iamchriskelley/half-pint-turbidimeter/README.md

#The half-pint turbidimeter
###An awesome water quality monitor about the size of a fist.

Written description coming soon. For now, here's a photo.

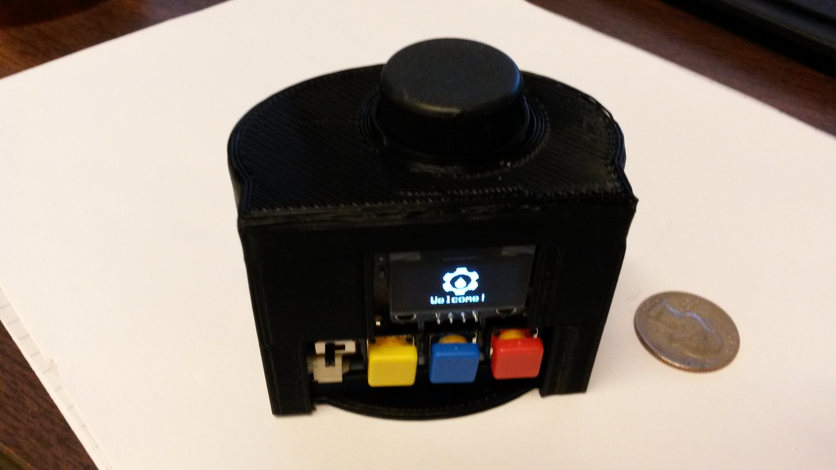
[picture p1: documentation/half-pint-turbidimeter_photo.jpg]
