iamchriskelley/half-pint-turbidimeter/hardware/half-pint-turbidimeter_tsl230rd_tsl267_1.0.1.brd

## EAGLE design hardware/half-pint-turbidimeter_tsl230rd_tsl267_1.0.1.brd (2017-01-15)

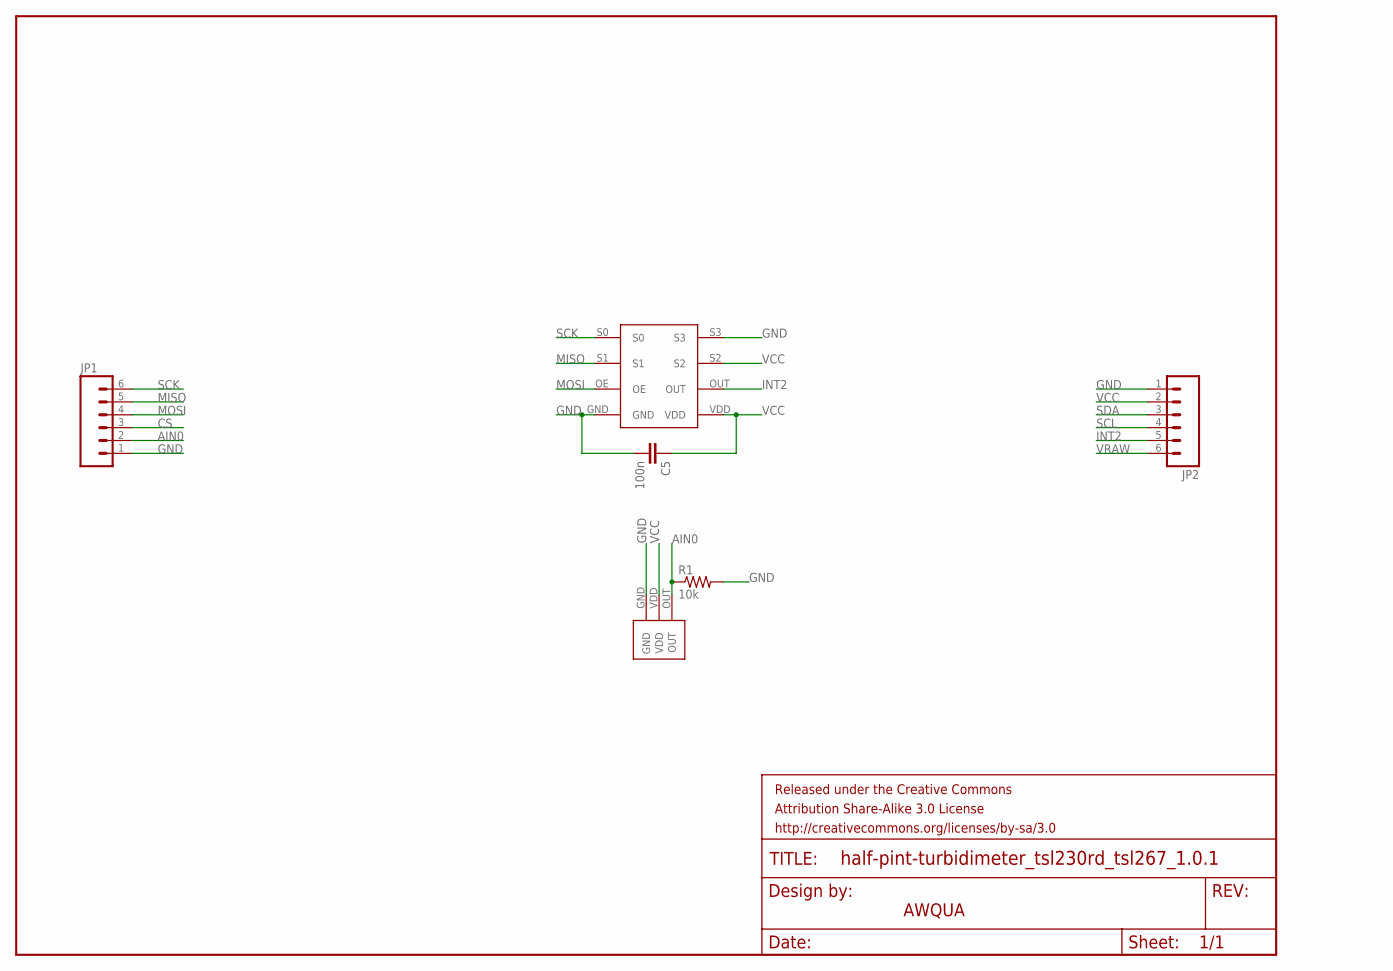
[picture p2: schematic half-pint-turbidimeter_tsl230rd_tsl267_1.0.1.sch]

Parts:
C5: 100n; 0603-CAP
FRAME1: FRAME-LETTER; CREATIVE_COMMONS
JP1, JP2: M06SIP; 1X06
R1: 10k; 0603-RES
U$1: TSL267
U$6: TSL230RDSMD; TSL230RD

Connections:
AIN0: JP1.2, R1.1, U$1.OUT
CS: JP1.3
GND: C5.2, JP1.1, JP2.1, R1.2, U$1.GND, U$6.GND, U$6.S3
INT2: JP2.5, U$6.OUT
MISO: JP1.5, U$6.S1
MOSI: JP1.4, U$6.OE
SCK: JP1.6, U$6.S0
SCL: JP2.4
SDA: JP2.3
VCC: C5.1, JP2.2, U$1.VDD, U$6.S2, U$6.VDD
VRAW: JP2.6

Notes on the sheet:
AWQUA

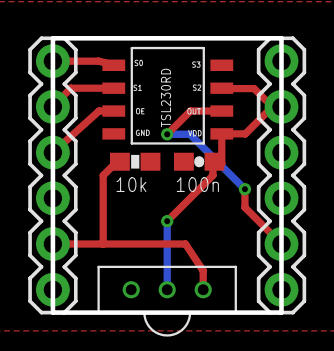
[picture p3: board half-pint-turbidimeter_tsl230rd_tsl267_1.0.1.brd from above]

Board: 2 copper layers, 12.7 x 15.2 mm, 8 parts (1 on the bottom side), 7 nets.

Other parts of the board:
U$5: OSHW-LOGO-S
