iamchriskelley/half-pint-turbidimeter/hardware/half-pint-turbidimeter_2.0.2.brd

## EAGLE design hardware/half-pint-turbidimeter_2.0.2.brd (2017-01-15)

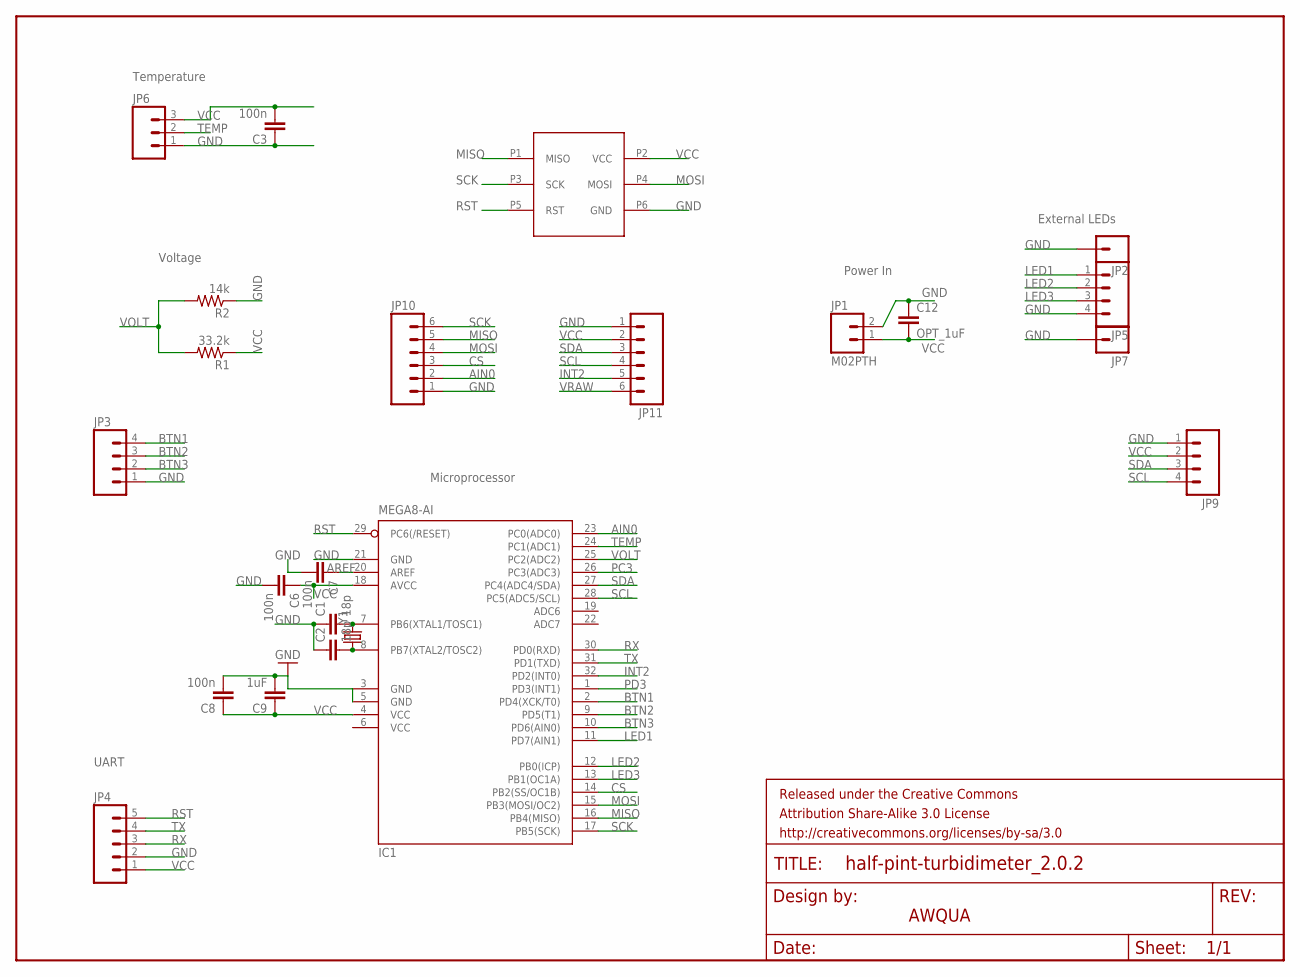
[picture p4: schematic half-pint-turbidimeter_2.0.2.sch]

Parts:
C1, C2: 18p; 0603-CAP
C3, C6, C7, C8: 100n; 0603-CAP
C9: 1uF; 0603-CAP
C12: OPT_1uF; 0603-CAP
FRAME1: FRAME-LETTER; CREATIVE_COMMONS
IC1: MEGA8-AI; TQFP32-08
JP1: M02PTH; 1X02
JP2, JP7: M01PTH; 1X01
JP3, JP5, JP9: M04PTH; 1X04
JP4: M05PTH; 1X05
JP6: M03PTH; 1X03
JP10, JP11: M06SMD_MALE; 1X06_SMD_MALE
R1: 33.2k; 0603-RES
R2: 14k; 0603-RES
U$1: ISP-SMD-6PIN
Y1: CRYSTAL5X3; CRYSTAL-SMD-5X3

Connections:
AIN0: IC1.23 (PC0(ADC0)), JP10.2
AREF: C7.1, IC1.20 (AREF)
BTN1: IC1.2 (PD4(XCK/T0)), JP3.4
BTN2: IC1.9 (PD5(T1)), JP3.3
BTN3: IC1.10 (PD6(AIN0)), JP3.2
CS: IC1.14 (PB2(SS/OC1B)), JP10.3
GND: C1.1, C2.1, C3.1, C6.2, C7.2, C8.2, C9.2, C12.1, IC1.3 (GND), IC1.5 (GND), IC1.21 (GND), JP1.2, JP2.1, JP3.1, JP4.2, JP5.4, JP6.1, JP7.1, JP9.1, JP10.1, JP11.1, R2.1, U$1.P6 (GND)
INT2: IC1.32 (PD2(INT0)), JP11.5
LED1: IC1.11 (PD7(AIN1)), JP5.1
LED2: IC1.12 (PB0(ICP)), JP5.2
LED3: IC1.13 (PB1(OC1A)), JP5.3
MISO: IC1.16 (PB4(MISO)), JP10.5, U$1.P1 (MISO)
MOSI: IC1.15 (PB3(MOSI/OC2)), JP10.4, U$1.P4 (MOSI)
PC3: IC1.26 (PC3(ADC3))
PD3: IC1.1 (PD3(INT1))
Q1: C2.2, IC1.8 (PB7(XTAL2/TOSC2)), Y1.1
Q2: C1.2, IC1.7 (PB6(XTAL1/TOSC1)), Y1.3 (2)
RST: IC1.29 (PC6(/RESET)), JP4.5, U$1.P5 (RST)
RX: IC1.30 (PD0(RXD)), JP4.3
SCK: IC1.17 (PB5(SCK)), JP10.6, U$1.P3 (SCK)
SCL: IC1.28 (PC5(ADC5/SCL)), JP9.4, JP11.4
SDA: IC1.27 (PC4(ADC4/SDA)), JP9.3, JP11.3
TEMP: IC1.24 (PC1(ADC1)), JP6.2
TX: IC1.31 (PD1(TXD)), JP4.4
VCC: C3.2, C6.1, C8.1, C9.1, C12.2, IC1.4 (VCC), IC1.6 (VCC), IC1.18 (AVCC), JP1.1, JP4.1, JP6.3, JP9.2, JP11.2, R1.1, U$1.P2 (VCC)
VOLT: IC1.25 (PC2(ADC2)), R1.2, R2.2
VRAW: JP11.6

Notes on the sheet:
AWQUA
Temperature
Voltage
UART
Microprocessor
Power In
External LEDs

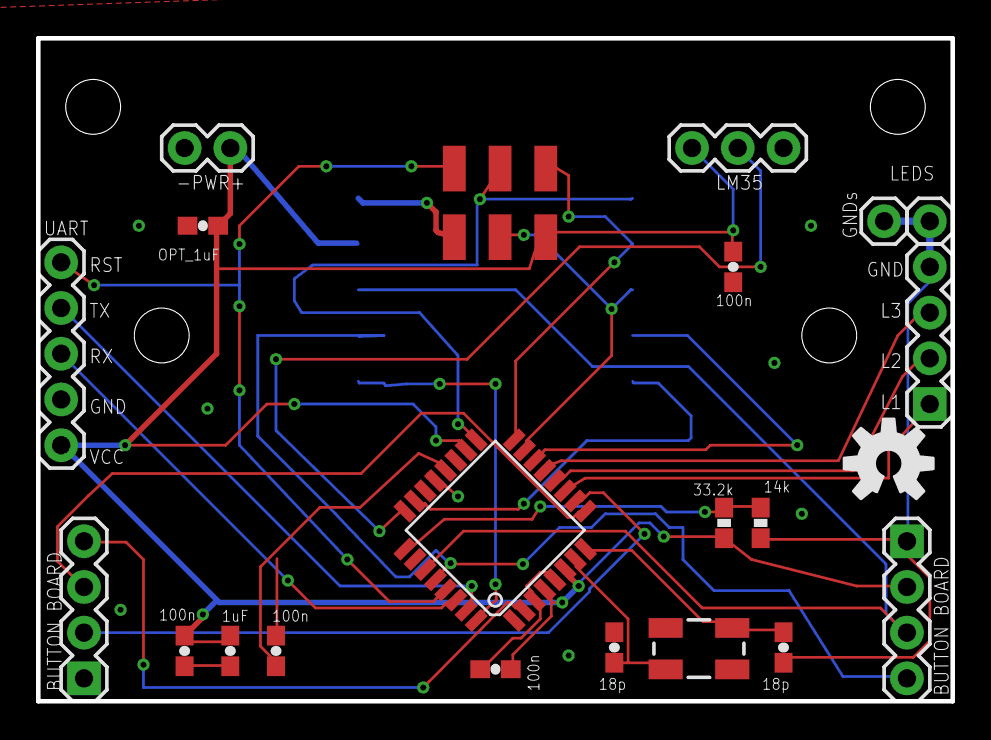
[picture p5: board half-pint-turbidimeter_2.0.2.brd from above]

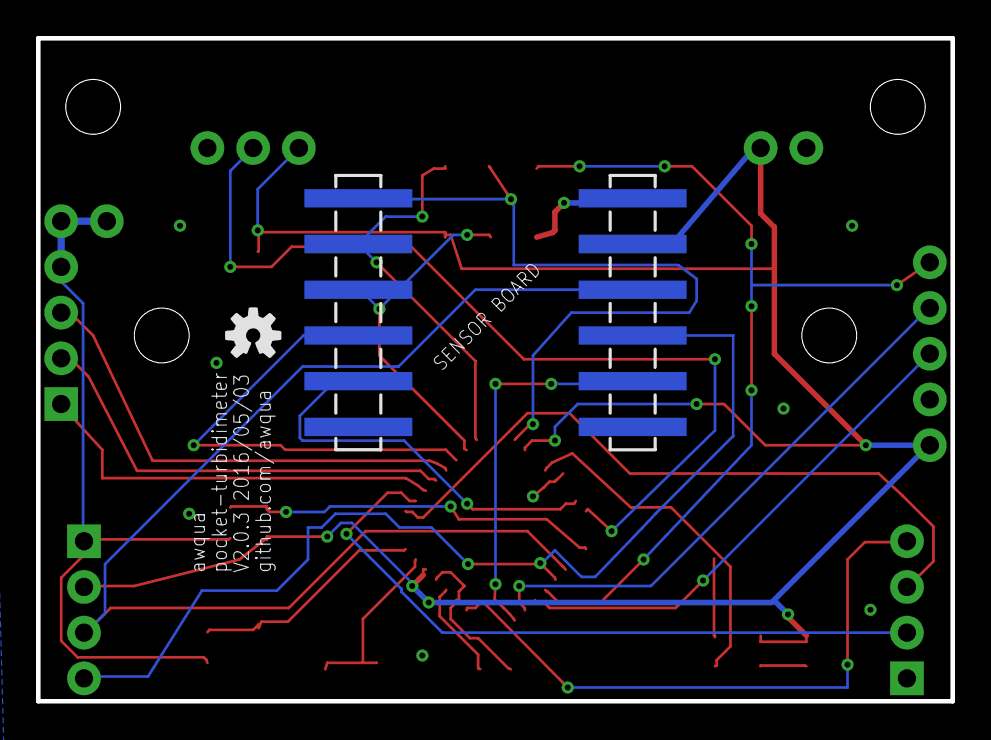
[picture p6: board half-pint-turbidimeter_2.0.2.brd from below]

Board: 2 copper layers, 50.8 x 36.8 mm, 26 parts (3 on the bottom side), 24 nets.

Other parts of the board:
U$4: OSHW-LOGO-M
U$5: OSHW-LOGO-S
