iamchriskelley/half-pint-turbidimeter/hardware/half-pint-turbidimeter_power.brd

## EAGLE design hardware/half-pint-turbidimeter_power.brd (2016-04-19)

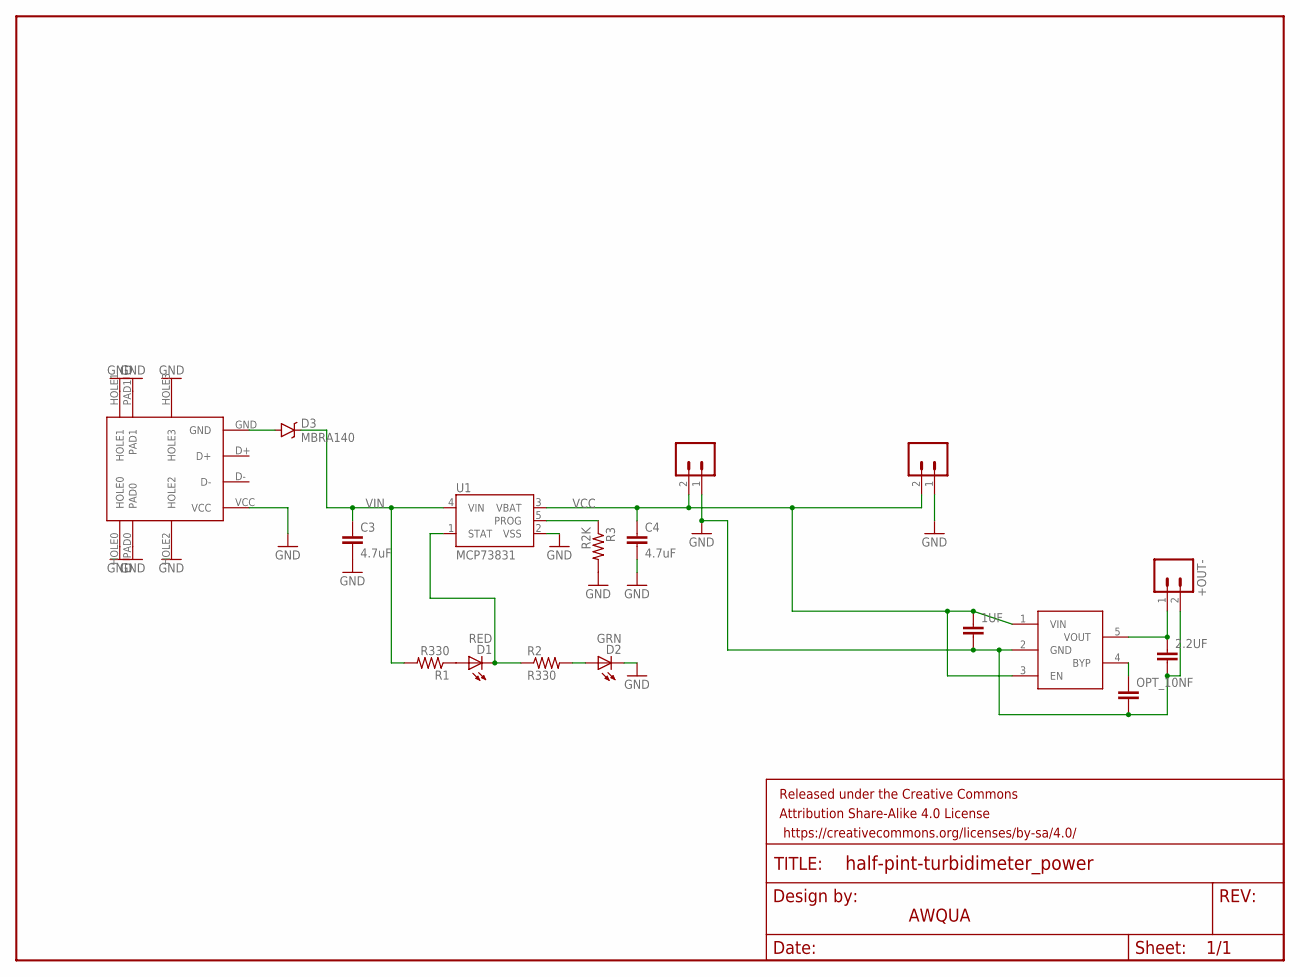
[picture p7: schematic half-pint-turbidimeter_power.sch]

Parts:
1UF, 2.2UF: CAP0603-CAP; 0603-CAP
+OUT-: M02PTH; 1X02
C3, C4: 4.7uF; 0402-CAP
D1: RED; LED-0603
D2: GRN; LED-0603
D3: MBRA140; SMA-DIODE
FRAME1: FRAME-LETTER; CREATIVE_COMMONS
JMP: M02PTH; 1X02
JP7: LiPo Battery; JST-2-SMD
OPT_10NF: CAP0603-CAP; 0603-CAP
R1, R2: R330; 0402-RES
R3: R2K; 0402-RES
U1: MCP73831; SOT23-5
U$2: LP2985
U$3: USBMICRO-DX4R005JJ2

Connections:
GND: 1UF.2, 2.2UF.2, +OUT-.2, C3.2, C4.2, D2.C, JMP.1, JP7.1, OPT_10NF.2, R3.2, U1.2 (VSS), U$2.2 (GND), U$3.HOLE0, U$3.HOLE1, U$3.HOLE2, U$3.HOLE3, U$3.PAD0, U$3.PAD1, U$3.VCC
unnamed: OPT_10NF.1, U$2.4 (BYP)
unnamed: D2.A, R2.2
unnamed: D1.A, R1.1
unnamed: 2.2UF.1, +OUT-.1, U$2.5 (VOUT)
unnamed: D3.A, U$3.GND
PROG: R3.1, U1.5 (PROG)
STAT: D1.C, R2.1, U1.1 (STAT)
VCC: 1UF.1, C4.1, JMP.2, JP7.2, U1.3 (VBAT), U$2.1 (VIN), U$2.3 (EN)
VIN: C3.1, D3.C, R1.2, U1.4 (VIN)

Notes on the sheet:
AWQUA

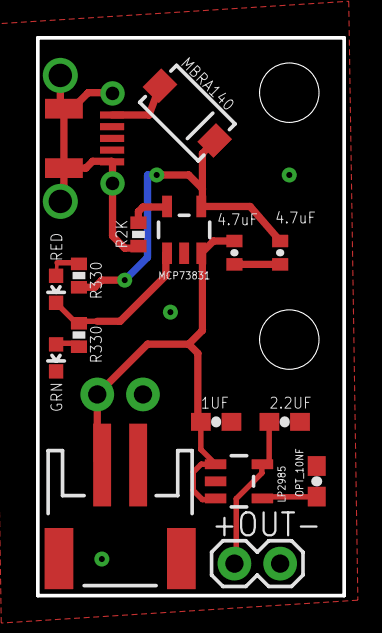
[picture p8: board half-pint-turbidimeter_power.brd from above]

Board: 2 copper layers, 17.0 x 31.0 mm, 21 parts (1 on the bottom side), 10 nets.

Other parts of the board:
JP1, JP3: STAND-OFF
U$1: CREATIVE_COMMONS
