iamchriskelley/half-pint-turbidimeter/hardware/half-pint-turbidimeter_led.brd

## EAGLE design hardware/half-pint-turbidimeter_led.brd (2016-03-31)

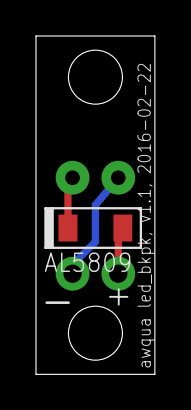
[picture p9: board half-pint-turbidimeter_led.brd from above]

Board: 2 copper layers, 6.6 x 18.8 mm, 4 parts (1 on the bottom side), 3 nets.

Parts:
D1: LED5MM
JP1: 1X02_NO_SILK
U$1: AL5809
U$2: CREATIVE_COMMONS

Connections:
$N1: D1.A, U$1.OUT
GND: D1.K, JP1.1
VCC: JP1.2, U$1.IN
