iamchriskelley/half-pint-turbidimeter/hardware/half-pint-turbidimeter_controls_2.0.1.brd

## EAGLE design hardware/half-pint-turbidimeter_controls_2.0.1.brd (2016-03-29)

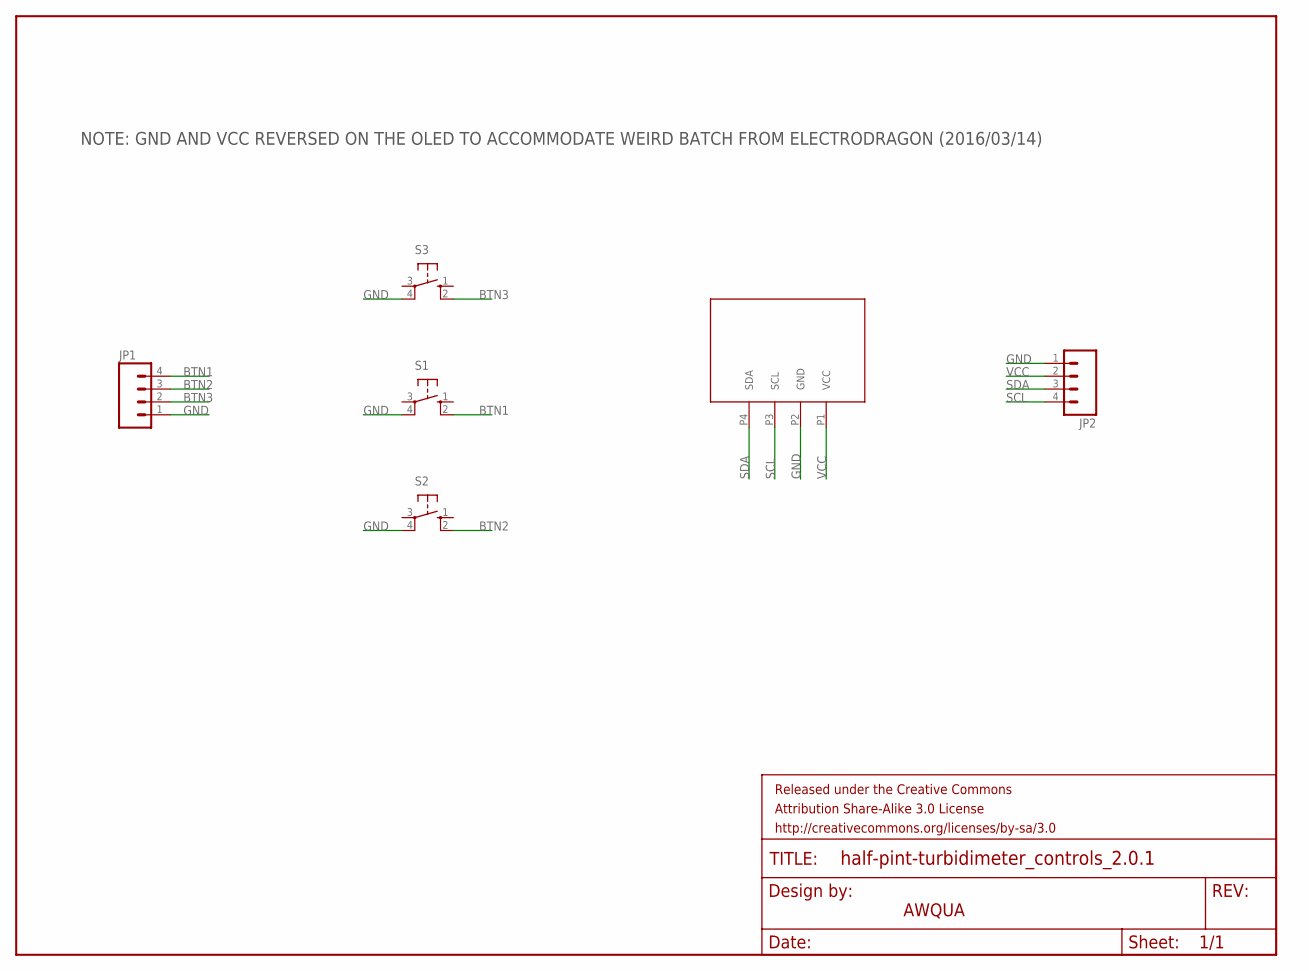
[picture p10: schematic half-pint-turbidimeter_controls_2.0.1.sch]

Parts:
FRAME1: FRAME-LETTER; CREATIVE_COMMONS
JP1, JP2: M04PTH; 1X04
S1, S2, S3: 40-XX; B3F-40XX
U$2: I2C-OLED-096

Connections:
BTN1: JP1.4, S1.2 (S1)
BTN2: JP1.3, S2.2 (S1)
BTN3: JP1.2, S3.2 (S1)
GND: JP1.1, JP2.1, S1.4 (P1), S2.4 (P1), S3.4 (P1), U$2.P2 (GND)
SCL: JP2.4, U$2.P3 (SCL)
SDA: JP2.3, U$2.P4 (SDA)
VCC: JP2.2, U$2.P1 (VCC)

Notes on the sheet:
AWQUA
NOTE: GND AND VCC REVERSED ON THE OLED TO ACCOMMODATE WEIRD BATCH FROM ELECTRODRAGON (2016/03/14)

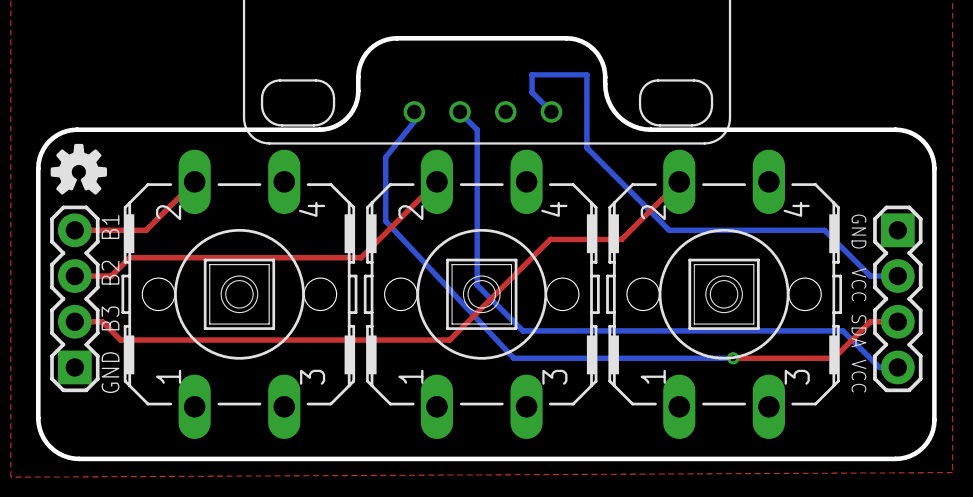
[picture p11: board half-pint-turbidimeter_controls_2.0.1.brd from above]

Board: 2 copper layers, 49.8 x 23.4 mm, 9 parts (1 on the bottom side), 7 nets.

Other parts of the board:
U$1: OSHW-LOGO-S
U$4: OSHW-LOGO-M
