iamchriskelley/half-pint-turbidimeter/testing/half_pint_turbidimeter_testing_20160509.xlsx

Half-pint turbidimeter calibration, 2016/05/09, for Cornell POST team
Validation data
Half-pint turbidimeter readings |  |  | MicroTPI readings |  |  | mean(half-pint) | mean(microtpi) | NTU difference | % difference
495.9 | 494.12 | 495.66 | 502.8 | 502.5 | 502.8 | 502.7 | 495.2266667 | 7.473333333 | 0.01486638817
370.67 | 370.62 | 370.67 | 378.7 | 378.4 | 378.5 | 378.5333333 | 370.6533333 | 7.88 | 0.02081718915
288.8 | 288.42 | 288.03 | 290.5 | 289.8 | 291 | 290.4333333 | 288.4166667 | 2.016666667 | 0.006943647423
153.86 | 153.29 | 153.16 | 147 | 147.9 | 163.5 | 152.8 | 153.4366667 | -0.6366666667 | -0.004166666667
74.98 | 75.09 | 75.14 | 72.86 | 72.98 | 73.12 | 72.98666667 | 75.07 | -2.083333333 | -0.02854402631
34.5 | 34.43 | 34.48 | 33.75 | 34.29 | 34.63 | 34.22333333 | 34.47 | -0.2466666667 | -0.007207558196
19.52 | 19.49 | 19.55 | 18.51 | 18.63 | 18.68 | 18.60666667 | 19.52 | -0.9133333333 | -0.04908634898
6.81 | 6.81 | 6.79 | 6.73 | 6.83 | 6.69 | 6.75 | 6.803333333 | -0.05333333333 | -0.007901234568
3.39 | 3.38 | 3.44 | 3.33 | 3.11 | 3.08 | 3.173333333 | 3.403333333 | -0.23 | -0.0724789916
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
