iamchriskelley/half-pint-turbidimeter/(commit log)

2016-03-29 imported main, interface boards
    [half-pint-turbidimeter_2.0.1.brd, half-pint-turbidimeter_2.0.1.sch, half-pint-turbidimeter_controls_2.0.1.brd, half-pint-turbidimeter_controls_2.0.1.sch, half-pint-turbidimeter_controls_2.0.1__OLED_gnd_vcc_reversed.brd, half-pint-turbidimeter_controls_2.0.1__OLED_gnd_vcc_reversed.sch, half-pint-turbidimeter_led.brd, half-pint-turbidimeter_led.sch]
2016-03-30 next version started
    [half-pint-turbidimeter_2.0.2.brd, half-pint-turbidimeter_2.0.2.sch]
2016-03-30 updating v2.0.2
    [half-pint-turbidimeter_2.0.2.brd, half-pint-turbidimeter_2.0.2.sch]
2016-03-31 minor edits to eagle schematics
    [half-pint-turbidimeter_2.0.1.brd, half-pint-turbidimeter_2.0.2.brd, half-pint-turbidimeter_led.brd, half-pint-turbidimeter_led.sch, half-pint-turbidimeter_power.brd, half-pint-turbidimeter_power.sch]
2016-04-01 airwire fixed
    [half-pint-turbidimeter_2.0.2.brd]
2016-04-01 fixed a label, added smd icsp
    [half-pint-turbidimeter_2.0.2.brd]
2016-04-05 added helper board for led wires
    [half-pint-turbidimeter_led_wires.brd, half-pint-turbidimeter_led_wires.sch]
2016-04-07 added voltage protection diode
    [half-pint-turbidimeter_power.brd, half-pint-turbidimeter_power.sch]
2016-04-12 added draft of revised caseware
    [DRAFT_half-pint-turbidimeter_case.scad]
2016-04-19 minor edits
    [half-pint-turbidimeter_power.brd]
2016-04-19 label edits
    [half-pint-turbidimeter_power.brd]
2017-01-15 hardware updates
    [half-pint-turbidimeter_2.0.2.brd, half-pint-turbidimeter_2.0.2.sch, half-pint-turbidimeter_tsl230rd_tsl267_1.0.1.brd, half-pint-turbidimeter_tsl230rd_tsl267_1.0.1.sch, half_pint_turbidimeter_testing_20160509.xlsx]
